r-schouten/ESP32_energy_meter/esp32_energy_meter.kicad_pcb

## KiCad design esp32_energy_meter.kicad_pcb (2021-07-30)

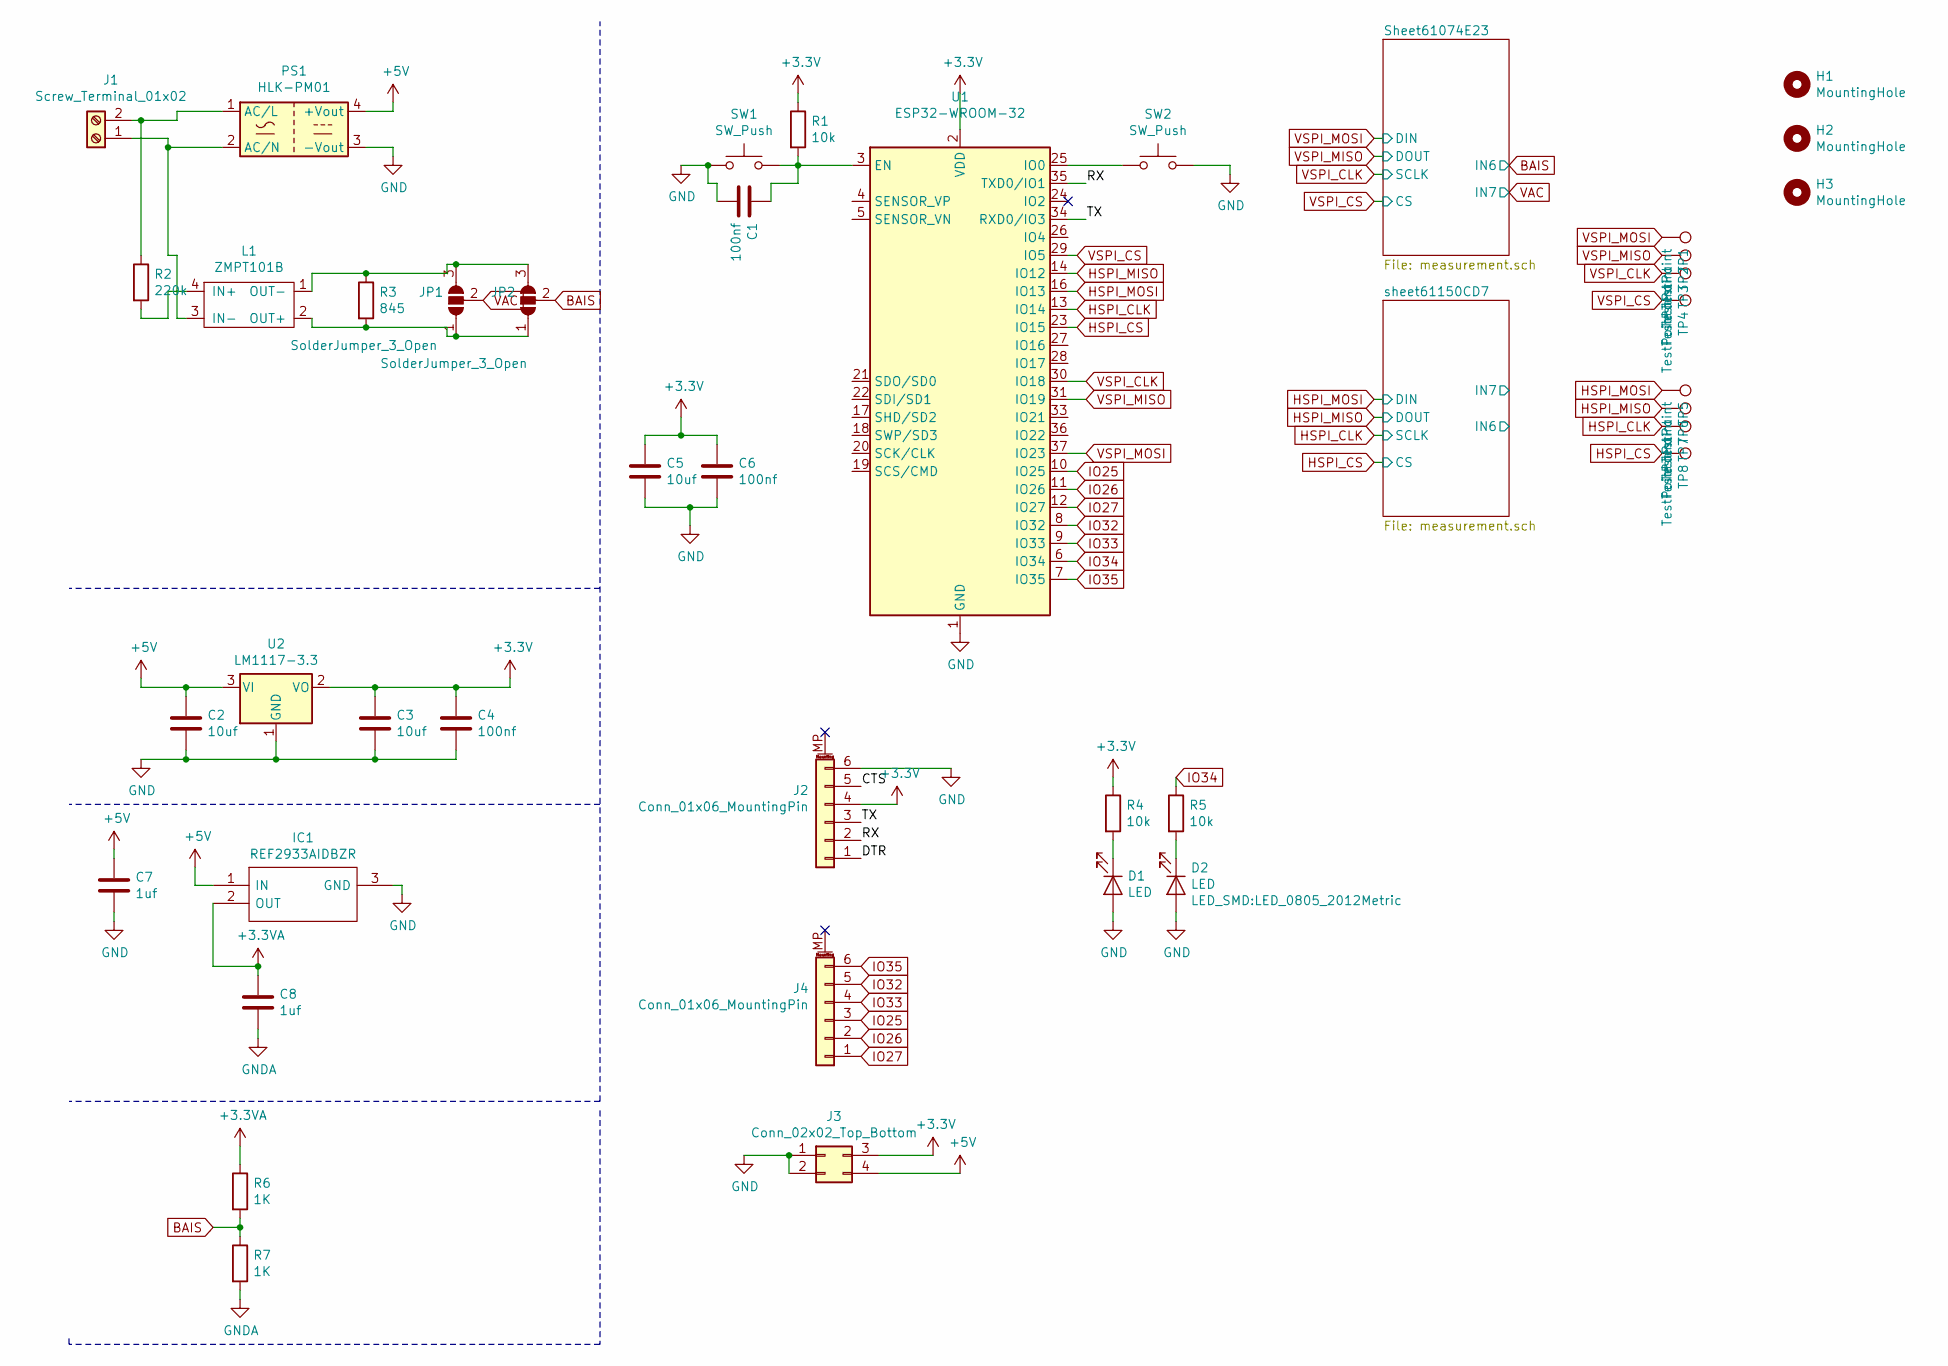
[picture p1: schematic esp32_energy_meter.sch]

Parts:
C1, C4, C6: 100nf; C_0805_2012Metric_Pad1.15x1.40mm_HandSolder; LCSC C62912
C2, C3, C5: 10uf; C_0805_2012Metric_Pad1.15x1.40mm_HandSolder; LCSC C90544
C7, C8: 1uf; C_0805_2012Metric_Pad1.15x1.40mm_HandSolder; LCSC C215803
D1, D2: LED; LED_0805_2012Metric; LCSC C131244
H1, H2, H3: MountingHole; MountingHole_3.2mm_M3; LCSC x
IC1: REF2933AIDBZR; SOT95P237X112-3N; Mouser Part Number 595-REF2933AIDBZR
J1: Screw_Terminal_01x02; TerminalBlock_bornier-2_P5.08mm; LCSC C8269
J2, J4: Conn_01x06_MountingPin; PinHeader_1x06_P2.54mm_Vertical; LCSC x
J3: Conn_02x02_Top_Bottom; PinHeader_2x02_P2.54mm_Vertical; LCSC x
JP1, JP2: SolderJumper_3_Open; SolderJumper-3_P1.3mm_Open_RoundedPad1.0x1.5mm; LCSC x
L1: ZMPT101B; LCSC C111858
PS1: HLK-PM01; Converter_ACDC_HiLink_HLK-PMxx; LCSC C209903
R1, R4, R5: 10k; R_0805_2012Metric; LCSC C25612
R2: 220k; R_2512_6332Metric; LCSC C175527
R3: 845; R_0805_2012Metric; LCSC C425484
R6, R7: 1K; R_0805_2012Metric; LCSC C95781
SW1, SW2: SW_Push; K2-1107ST; LCSC x
TP1, TP2, TP3, TP4, TP5, TP6, TP7, TP8: TestPoint; TestPoint_Pad_1.0x1.0mm; LCSC x
U1: ESP32-WROOM-32; LCSC C82899
U2: LM1117-3.3; SOT-223; LCSC C23984

Connections:
+3.3VA: C8.1, IC1.2 (OUT), R6.1; also elsewhere on the board
+3V3: C3.1, C4.1, C5.1, C6.1, J2.4, J3.3, R1.1, R4.1, U1.2 (VDD), U2.2 (VO); also elsewhere on the board
+5V: C2.1, C7.1, IC1.1 (IN), J3.4, PS1.4 (+Vout), U2.3 (VI)
/CTS: J2.5
/DTR: J2.1
/RX: J2.2, U1.35 (TXD0/IO1)
/TX: J2.3, U1.34 (RXD0/IO3)
BAIS: JP2.2 (C), R6.2, R7.1; also elsewhere on the board
GND: C1.2, C2.2, C3.2, C4.2, C5.2, C6.2, C7.2, D1.2 (A), D2.2 (A), IC1.3 (GND), J2.6, J3.1, J3.2, PS1.3 (-Vout), SW1.1, SW2.2, U1.1 (GND), U1.15 (GND), U1.38 (GND), U1.39 (GND), U2.1 (GND); also elsewhere on the board
GNDA: C8.2, R7.2; also elsewhere on the board
HSPI_CLK: TP7.1, U1.13 (IO14); also elsewhere on the board
HSPI_CS: TP8.1, U1.23 (IO15); also elsewhere on the board
HSPI_MISO: TP6.1, U1.14 (IO12); also elsewhere on the board
HSPI_MOSI: TP5.1, U1.16 (IO13); also elsewhere on the board
IO25: J4.3, U1.10 (IO25)
IO26: J4.2, U1.11 (IO26)
IO27: J4.1, U1.12 (IO27)
IO32: J4.5, U1.8 (IO32)
IO33: J4.4, U1.9 (IO33)
IO34: R5.1, U1.6 (IO34)
IO35: J4.6, U1.7 (IO35)
unnamed: C1.1, R1.2, SW1.2, U1.3 (EN)
unnamed: D1.1 (K), R4.2
unnamed: D2.1 (K), R5.2
unnamed: J1.1, L1.3 (IN-), PS1.2 (AC/N)
unnamed: J1.2, PS1.1 (AC/L), R2.1
unnamed: JP1.1 (A), JP2.1 (A), L1.2 (OUT+), R3.2
unnamed: JP1.3 (B), JP2.3 (B), L1.1 (OUT-), R3.1
unnamed: L1.4 (IN+), R2.2
unnamed: SW2.1, U1.25 (IO0)
VAC: JP1.2 (C); also elsewhere on the board
VSPI_CLK: TP3.1, U1.30 (IO18); also elsewhere on the board
VSPI_CS: TP4.1, U1.29 (IO5); also elsewhere on the board
VSPI_MISO: TP2.1, U1.31 (IO19); also elsewhere on the board
VSPI_MOSI: TP1.1, U1.37 (IO23); also elsewhere on the board

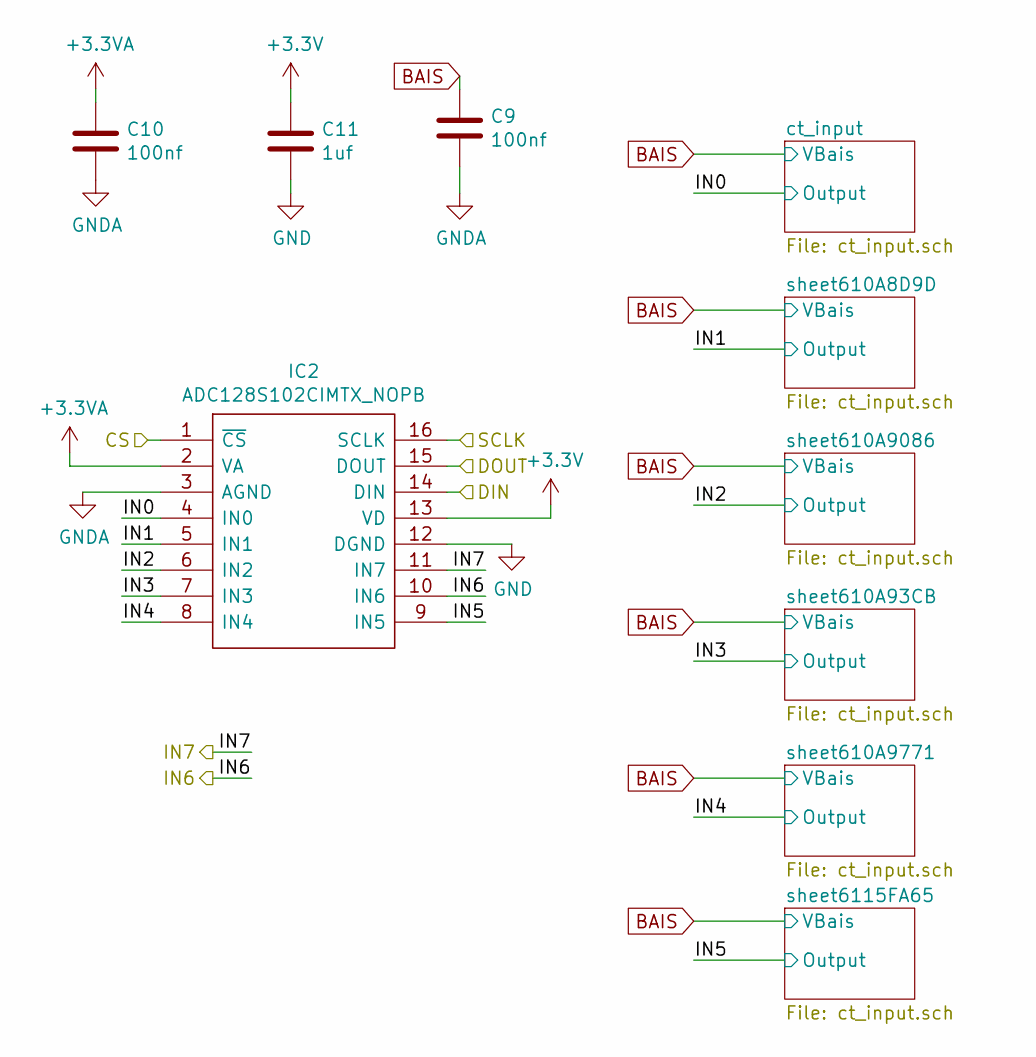
[picture p2: schematic measurement.sch]

Parts:
C12, C13: 100nf; C_0805_2012Metric_Pad1.15x1.40mm_HandSolder; LCSC C62912
C14: 1uf; C_0805_2012Metric_Pad1.15x1.40mm_HandSolder; LCSC C215803
IC3: ADC128S102CIMTX_NOPB; SOP65P640X120-16N; Mouser Part Number 926-A128S102CIMTXNPB

Connections:
+3.3VA: C13.1, IC3.2 (VA); also elsewhere on the board
+3V3: C14.1, IC3.13 (VD); also elsewhere on the board
/Sheet61074E23/IN0: IC3.4 (IN0); also elsewhere on the board
/Sheet61074E23/IN1: IC3.5 (IN1); also elsewhere on the board
/Sheet61074E23/IN2: IC3.6 (IN2); also elsewhere on the board
/Sheet61074E23/IN3: IC3.7 (IN3); also elsewhere on the board
/Sheet61074E23/IN4: IC3.8 (IN4); also elsewhere on the board
/Sheet61074E23/IN5: IC3.9 (IN5); also elsewhere on the board
BAIS: C12.1, IC3.10 (IN6); also elsewhere on the board
GND: C14.2, IC3.12 (DGND); also elsewhere on the board
GNDA: C12.2, C13.2, IC3.3 (AGND); also elsewhere on the board
VAC: IC3.11 (IN7); also elsewhere on the board
VSPI_CLK: IC3.16 (SCLK); also elsewhere on the board
VSPI_CS: IC3.1 (~CS); also elsewhere on the board
VSPI_MISO: IC3.15 (DOUT); also elsewhere on the board
VSPI_MOSI: IC3.14 (DIN); also elsewhere on the board

Parts of its further copies:
C9, C10: 100nf; C_0805_2012Metric_Pad1.15x1.40mm_HandSolder; LCSC C62912
C11: 1uf; C_0805_2012Metric_Pad1.15x1.40mm_HandSolder; LCSC C215803
IC2: ADC128S102CIMTX_NOPB; SOP65P640X120-16N; Mouser Part Number 926-A128S102CIMTXNPB

Connections of its further copies:
+3.3VA: C10.1, IC2.2 (VA); also elsewhere on the board
+3V3: C11.1, IC2.13 (VD); also elsewhere on the board
/sheet61150CD7/IN0: IC2.4 (IN0); also elsewhere on the board
/sheet61150CD7/IN1: IC2.5 (IN1); also elsewhere on the board
/sheet61150CD7/IN2: IC2.6 (IN2); also elsewhere on the board
/sheet61150CD7/IN3: IC2.7 (IN3); also elsewhere on the board
/sheet61150CD7/IN4: IC2.8 (IN4); also elsewhere on the board
/sheet61150CD7/IN5: IC2.9 (IN5); also elsewhere on the board
/sheet61150CD7/IN6: IC2.10 (IN6)
/sheet61150CD7/IN7: IC2.11 (IN7)
BAIS: C9.1; also elsewhere on the board
GND: C11.2, IC2.12 (DGND); also elsewhere on the board
GNDA: C9.2, C10.2, IC2.3 (AGND); also elsewhere on the board
HSPI_CLK: IC2.16 (SCLK); also elsewhere on the board
HSPI_CS: IC2.1 (~CS); also elsewhere on the board
HSPI_MISO: IC2.15 (DOUT); also elsewhere on the board
HSPI_MOSI: IC2.14 (DIN); also elsewhere on the board

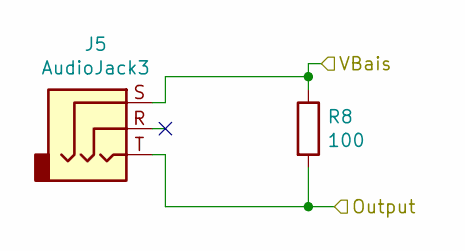
[picture p3: schematic ct_input.sch]

Parts:
J11: AudioJack3; C18594; LCSC C18594
R14: 100; R_0805_2012Metric; LCSC C478885

Connections:
/Sheet61074E23/IN0: J11.T, R14.2; also elsewhere on the board
BAIS: J11.S, R14.1; also elsewhere on the board

Parts of its further copies:
J5, J6, J7, J8, J9, J10, J12, J13, J14, J15, J16: AudioJack3; C18594; LCSC C18594
R8, R9, R10, R11, R12, R13, R15, R16, R17, R18, R19: 100; R_0805_2012Metric; LCSC C478885

Connections of its further copies:
/Sheet61074E23/IN1: J12.T, R15.2; also elsewhere on the board
/Sheet61074E23/IN2: J13.T, R16.2; also elsewhere on the board
/Sheet61074E23/IN3: J14.T, R17.2; also elsewhere on the board
/Sheet61074E23/IN4: J15.T, R18.2; also elsewhere on the board
/Sheet61074E23/IN5: J16.T, R19.2; also elsewhere on the board
/sheet61150CD7/IN0: J5.T, R8.2; also elsewhere on the board
/sheet61150CD7/IN1: J6.T, R9.2; also elsewhere on the board
/sheet61150CD7/IN2: J7.T, R10.2; also elsewhere on the board
/sheet61150CD7/IN3: J8.T, R11.2; also elsewhere on the board
/sheet61150CD7/IN4: J9.T, R12.2; also elsewhere on the board
/sheet61150CD7/IN5: J10.T, R13.2; also elsewhere on the board
BAIS: J5.S, J6.S, J7.S, J8.S, J9.S, J10.S, J12.S, J13.S, J14.S, J15.S, J16.S, R8.1, R9.1, R10.1, R11.1, R12.1, R13.1, R15.1, R16.1, R17.1, R18.1, R19.1; also elsewhere on the board

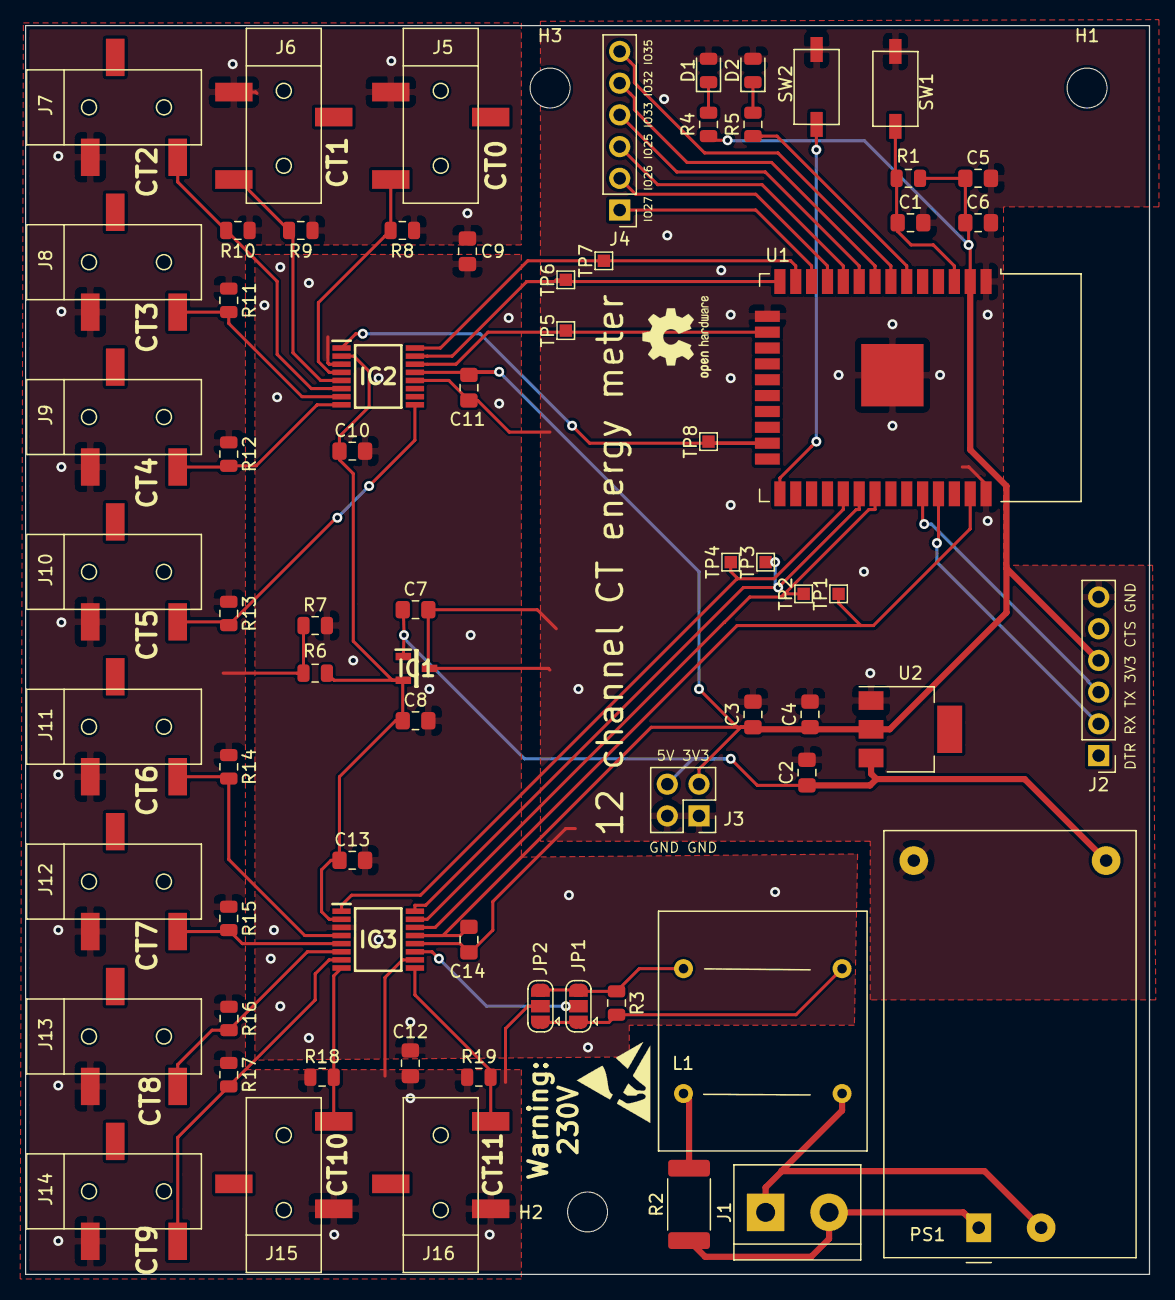
[picture p4: board esp32_energy_meter.kicad_pcb from above]

Board: 2 copper layers, 90.0 x 100.0 mm, 73 parts (0 on the bottom side), 45 nets.
